evaaan/NixieClock/README.md

# Nixie Clock

Nixie Tube Clock built from an STM32F4 dev board, custom PCB backplane, and an Aspen box.

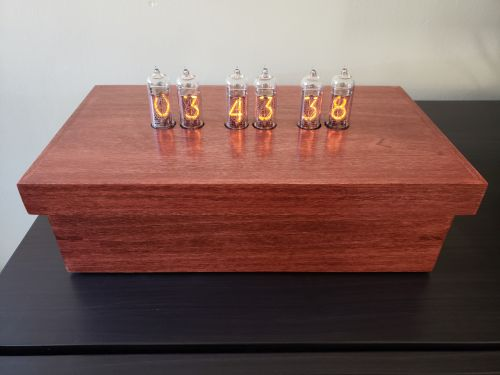
[picture p1: Images/image03.jpg]
Overview1


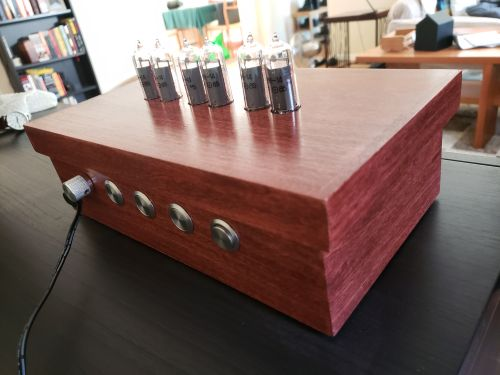
[picture p2: Images/image04.jpg]
Overview2


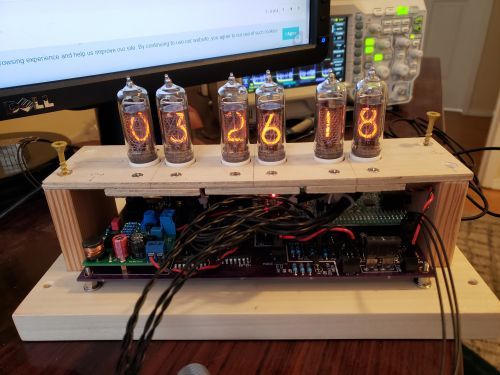
[picture p3: Images/image02.jpg]
Internals


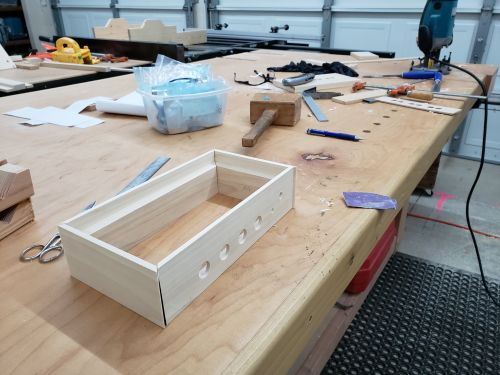
[picture p4: Images/image01.jpg]
Wood Shop
