evaaan/NixieClock/docs/clock.pptx

32.768kHz Crystal

5V Supply

170V DC/DC Supply

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
74141
Driver

0
1
9

10HR Nixie

SysTick 1Hz
tick=True

curr_hr
curr_min
curr_sec

GPIO_Init()
SysTick_Init()
LSE_RCC_Init()

tick?

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
74141
Driver

0
1
9

1HR Nixie

yes

def inc_sec(void){
If (curr_sec==59) {
curr_sec=0;
inc_min(); }
else curr_sec++}

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
74141
Driver

0
1
9

10MIN Nixie

inc_sec()
update_GPIO()

Btn_event?

void int2bcd(int) {
return <blah>
}
update_GPIO(void) {
bcd = int2bcd(curr_sec)
GPIOF0 = bcd & 0x1;
GPIOF1 = bcd & 0x2 >> 1;
GPIOF2 = bcd & 0x4 >> 2;
GPIOF3 = bcd & 0x8 >> 3;
GPIOE0 = bcd & 0x10 >> 4;
GPIOE1 = bcd & 0x20 >> 5;
GPIOE2 = bcd & 0x40 >> 6;
GPIOE3 = bcd & 0x80 >> 7;
<repeat for GPIO A-D>
}

def inc_min(void){
If (curr_min==59) {
curr_min=0;
inc_hr(); }
else curr_min++;}

def inc_hr(void){
If (curr_hr==12) {
curr_min=1; }
else curr_hr++}

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
74141
Driver

0
1
9

1MIN Nixie

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
74141
Driver

0
1
9

10SEC Nixie

<code to write curr_* from button states>

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
74141
Driver

0
1
9

1SEC Nixie

## Slide 2

32.768kHz Crystal

200V DC/DC Supply

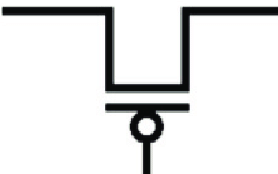
[picture p5: figure]

SysTick 1Hz
tick=True

74141
Driver

Main loop

tick?

GPIO

yes

no

inc_sec()
update_GPIO()
unset tick

buffer

DMA

ADC Continuous Polling

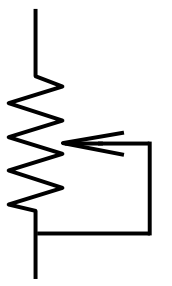
[picture p6: figure]

Interrupt when buffer is written

Set brightness_flag

brightness_flag?

no

Sec_flag?

yes

buffer

DMA

GPIO

yes

Interrupt when buffer is written

- Set pwm_rate
- Unset brightness_flag

- Debounce buffer
- Increment sec
- Unset sec_flag

Set sec_flag

## DEBUG

- Use SWD (Single Wire Debug)
- 6 pins
  - SWCLK (Clock) SWDIO (Data)
  - NRST (Reset)
  - SWO (Serial debug output)
  - GND
  - 3.3V
- Example: https://mcuoneclipse.com/2016/10/17/tutorial-using-single-wire-output-swo-with-arm-cortex-m-and-eclipse/

## Slide 4

HV Supply

Cortex M4

Transistors
Tubes

Nixie Tubes

GPIO
Potentiometers

M4 processor | LQFP64 package, STM32F405RGT6

## Slide 5

PWM Level

ADC

Brightness Potentiometer

Time Setting Increment

GPIO

Hour Set Pushbutton

Time Setting Increment

GPIO

Minute Set Pushbutton

Time Setting Increment

GPIO

Seconds Set Pushbutton

Time Set

GPIO

Date Set Pushbutton

## Slide 6

170V DC/DC Supply

10HR Nixie

GND

1HR Nixie

HR B12 Counter

MIN B60 Counter

10MIN Nixie

…

1MIN Nixie

32.768kHz Crystal

2¹⁵ Counter

SEC B60 Counter

10SEC Nixie

1SEC Nixie

GND

## Slide 7

## Slide 8

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
## Slide 9

## Slide 10

## Slide 11

7/8”
5/8” OD + ¼”

7/8”
5/8” OD + ¼”

7/8”
5/8” OD + ¼”

11/8”
5/8” OD + ¾”

11/8”
5/8” OD + ¾”

## Slide 12

#4, 2.97mm screw -> use 3.5

176.249, 96.348

153.749, 76.348

2.5mm

25.5mm

45mm

29mm

3mm

191.749, 69.848

22.5mm

8.5mm

150.749, 53.848

49mm
