evaaan/NixieClock/docs/calculations.xlsx

Sheet: Power
Vsupply | 180 | V
Vtube | 138 | V
Vres | 42 | V
Rseries | 22000 | Ω
Iseries | 1.909090909 | mA
Ptube | 263.4545455 | mW
Vinput | 5 | V
Vout | 180 | V
Itube | 2 | mA
Ptube | 360 | mW
Ptotal | 2160 | mW | Target 4W output power.
Efficiency | 50%
Pin | 8000 | mW
Iin | 1600 | mA
Turns,pri | 1
Turns,sec | 12
L,pri | 100 | uH
L, sec | 0.69 | uH
Vpri | 5 | V
duty | 75%
Vout | 180
f,typ | 100 | kHz
Fuse Sizing
Power | 4 | W
Voltage | 5 | V
Current | 0.8 | A

Sheet: 555 Timer
https://www.youtube.com/watch?v=i0SNb__dkYI&t=280s
8.3.2 A-stable Operation
coeff | 0.92
RA | 1000 | Ω
RB | 50000 | Ω
C | 4.7e-08 | F
tH | 0.00220524 | sec
tL | 0.0021620 | sec
freq | 228.98 | Hz
w/ Potentiometer & Diodes (maintain constant duty cycle)
coeff | 0.92
R1 | 1000 | Ω
R | 1000000 | Ω
Rgnd | 500000 | Ω
C1 | 4.7e-09 | F
tH | 0.0021663 | sec
tL | 0.0021620 | sec
freq | 231.04 | Hz
duty | 0.5005
min duty cycle
Vsupply | 200 | V
Vmin | 120 | V
duty,min | 0.6
Rpot | 1000000 | Ω
R1 | 1200000 | Ω

Sheet: PWM
NPN Level Shifter
PNP
Vsupply | 200 | V
R,upper | 4700 | Ω
R,lower | 440000 | Ω
VBE | -2.1 | V
I,res | 0.450 | mA
P,upper | 0.0009506564308 | W
P,lower | 0.08899762331 | W
Ic,gain | 100 | A/A
Ic | 5 | mA
Ib | 0.05 | mA

Sheet: Pins
 | GPIO | ADC
Nixie Tubes | 24
Buttons | 3
Brightness Setting |  | 1
HV PWM | 1
 | 28 | 1

Sheet: Spacing
NORMAL |  |  |  |  |  | WIDE |  |  |  |  |  | TIGHT
Nixie OD | 0.625 | in |  |  |  | Nixie OD | 0.625 | in |  |  |  | Nixie OD | 0.625 | in
Spacing,pair | 0.25 | in |  | Test | TRUE | Spacing,pair | 0.5 | in |  | Test | TRUE | Spacing,pair | 0.125 | in |  | Test | TRUE
Spacing,reg | 0.75 | in |  |  |  | Spacing,reg | 1 | in |  |  |  | Spacing,reg | 0.5 | in
Box Width | 10 | in |  |  |  | Box Width | 10 | in |  |  |  | Box Width | 10 | in
edge | 0 | in |  |  |  | edge | 0 | in |  |  |  | edge | 0 | in
D1 | 2.3125 | in | 2 | 0.3125 | in | D1 | 1.6875 | in | 1 | 0.6875 | in | D1 | 2.75 | in | 2 | 0.75 | in
D2 | 3.1875 | in | 3 | 0.1875 | in | D2 | 2.8125 | in | 2 | 0.8125 | in | D2 | 3.5 | in | 3 | 0.5 | in
D3 | 4.5625 | in | 4 | 0.5625 | in | D3 | 4.4375 | in | 4 | 0.4375 | in | D3 | 4.625 | in | 4 | 0.625 | in
D4 | 5.4375 | in | 5 | 0.4375 | in | D4 | 5.5625 | in | 5 | 0.5625 | in | D4 | 5.375 | in | 5 | 0.375 | in
D5 | 6.8125 | in | 6 | 0.8125 | in | D5 | 7.1875 | in | 7 | 0.1875 | in | D5 | 6.5 | in | 6 | 0.5 | in
D6 | 7.6875 | in | 7 | 0.6875 | in | D6 | 8.3125 | in | 8 | 0.3125 | in | D6 | 7.25 | in | 7 | 0.25 | in
edge | 10 | in |  |  |  | edge | 10 | in |  |  |  | edge | 10 | in
