evaaan/NixieClock/Altium/Project Outputs for Nixie_Backplane/Nixie_Backplane_Schematic.PDF

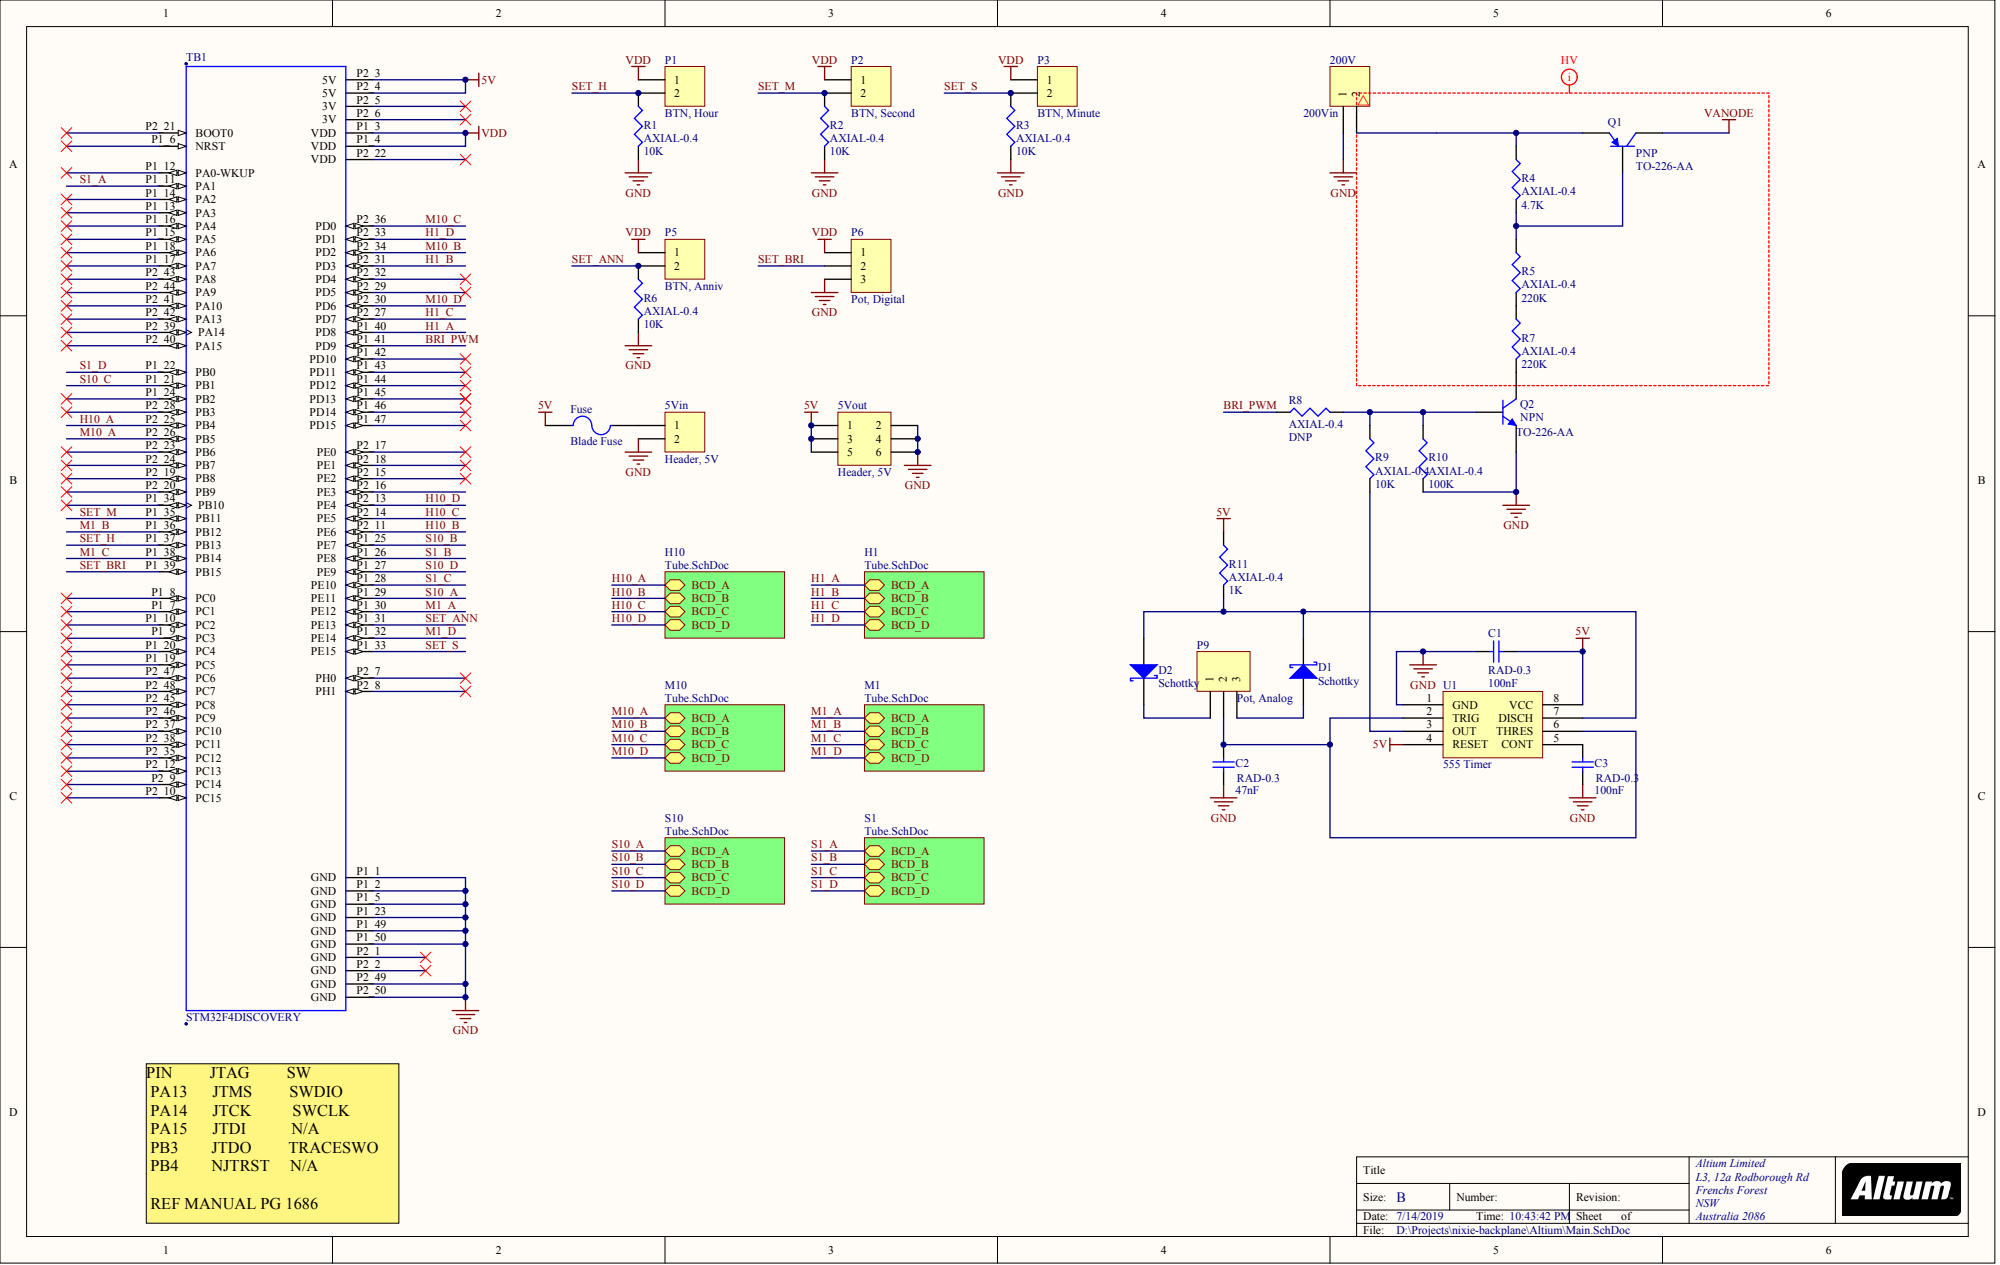
[picture p7: page 1]

P1_5
P1_23
P1_49
P1_50
P2_1 P2_2 P2_49

Title | Altium Limited L3, 12a Rodborough Rd Frenchs Forest NSW Australia 2086

B Size: | Number: | Revision:

7/14/2019 Time: 10:43:42 P M | | Sheet of

D:\Projects\nixie-backplane\Altium\Main.SchDoc

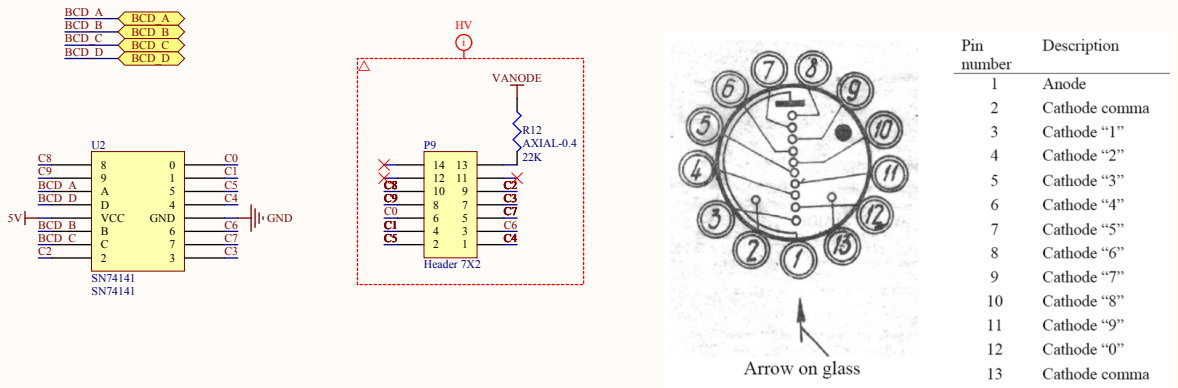
[picture p8: page 2]

Title | Altium Limited L3, 12a Rodborough Rd Frenchs Forest NSW Australia 2086

B Size: | Number: | Revision:

7/14/2019 Time: 10:43:42 P M | | Sheet of

D:\Projects\nixie-backplane\Altium\Tube.SchDoc
