evaaan/NixieClock/sims/combined.asc

C1: cap; 0.047µ
D1: schottky
D2: schottky
Q1: npn
Q2: pnp
R1: res; 1k
R2: res; 50K
R3: res; 50K
R4: res; 4.7K
R5: res; 220K
R6: res; 220K
R7: res; 200K
R8: res; 10K
U1: NE555
V1: voltage; 5V
V3: voltage; 200V
Named nets: 0, 5V, PWM
.tran 100ms
