evaaan/NixieClock/sims/555timer.asc

C1: cap; 0.047µ
D1: schottky
D2: schottky
Q1: npn
Q2: pnp
R1: res; 120000
R2: res; 0
R3: res; 100k
R4: res
R5: res
R6: res
R7: res
R8: res
U1: NE555
V1: voltage; 5V
V3: voltage
Named nets: 0, 5V, PWM
.tran 100ms
