evaaan/NixieClock/sims/pnp_shifter.asc

Q1: npn
Q3: pnp
R1: res; 1K
R2: res; 200K
R3: res; 220K
R4: res; 220K
R5: res; 4.7K
V1: voltage; 200V
V2: voltage
Named nets: 0
