evaaan/NixieClock/(list of files, drawings)

Other design files:
Altium/Main.SchDoc
Altium/Microcontroller.SchDoc
Altium/Nixie_Backplane.PrjPCB
Altium/Nixie_Backplane_PCB.PcbDoc
Altium/Power.SchDoc
Altium/Tube.SchDoc
