evaaan/NixieClock/(commit log)

2019-07-09 working commit
    [Main.SchDoc, Nixie_Backplane.PrjPCB, Tube.SchDoc]
2019-07-11 working copy of pcb
    [Nixie_Backplane_PCB.PcbDoc]
2019-07-14 first pass layout. DRC passes.
    [Main.SchDoc, Nixie_Backplane.PrjPCB, Nixie_Backplane_PCB.PcbDoc, Tube.SchDoc]
2019-07-14 updated power plane poly pours
    [Nixie_Backplane_PCB.PcbDoc]
2019-07-15 OshPark Order
    [Main.SchDoc, Nixie_Backplane.PrjPCB, Nixie_Backplane_PCB.PcbDoc, Tube.SchDoc]
